wj-zhe/thrfv/case/case_dxf/thrfv_case_bottom-Edge_Cuts.dxf

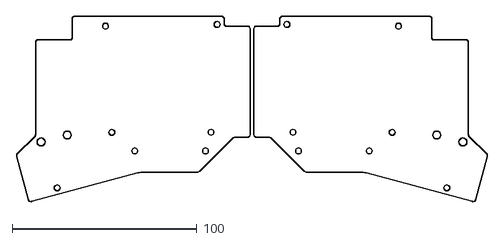
[picture p1: CAD file, 2023-05-11]
case/case_dxf/thrfv_case_bottom-Edge_Cuts.dxf
254.9 x 100.2
