wj-zhe/thrfv/case/encoder_on_left_no_joystick/case_dxf/thrfv_case_switch_plate-Edge_Cuts.dxf

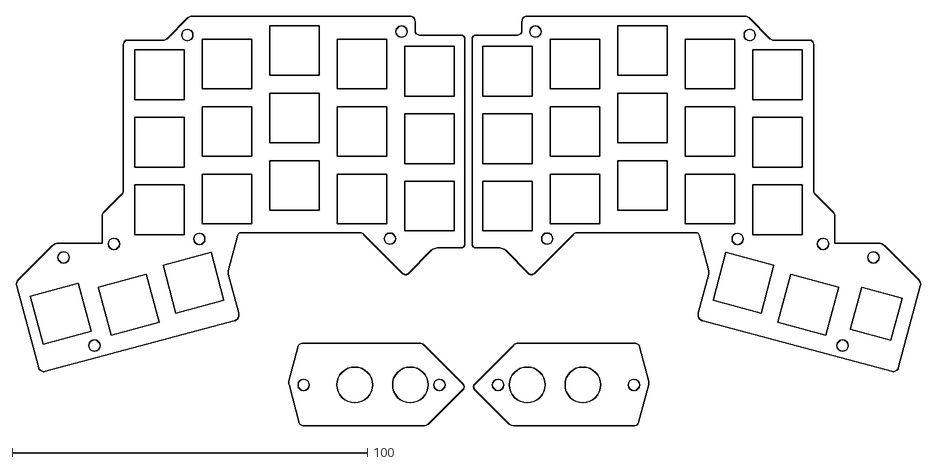
[picture p2: CAD file, 2023-05-11]
case/encoder_on_left_no_joystick/case_dxf/thrfv_case_switch_plate-Edge_Cuts.dxf
254.9 x 115.4
