wj-zhe/thrfv/case/encoder_on_left_no_joystick/case_dxf/thrfv_case_beneath_pcb-Edge_Cuts.dxf

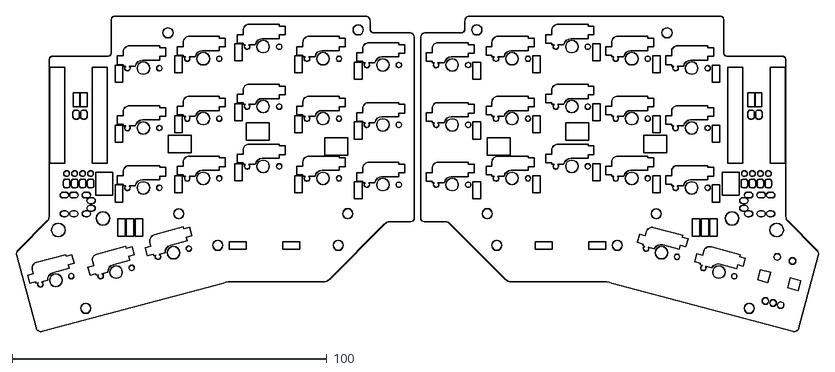
[picture p3: CAD file, 2023-05-11]
case/encoder_on_left_no_joystick/case_dxf/thrfv_case_beneath_pcb-Edge_Cuts.dxf
254.9 x 100.2
