wj-zhe/thrfv/PCB/thrfv.kicad_pcb

## KiCad design PCB/thrfv.kicad_pcb (2023-05-11)

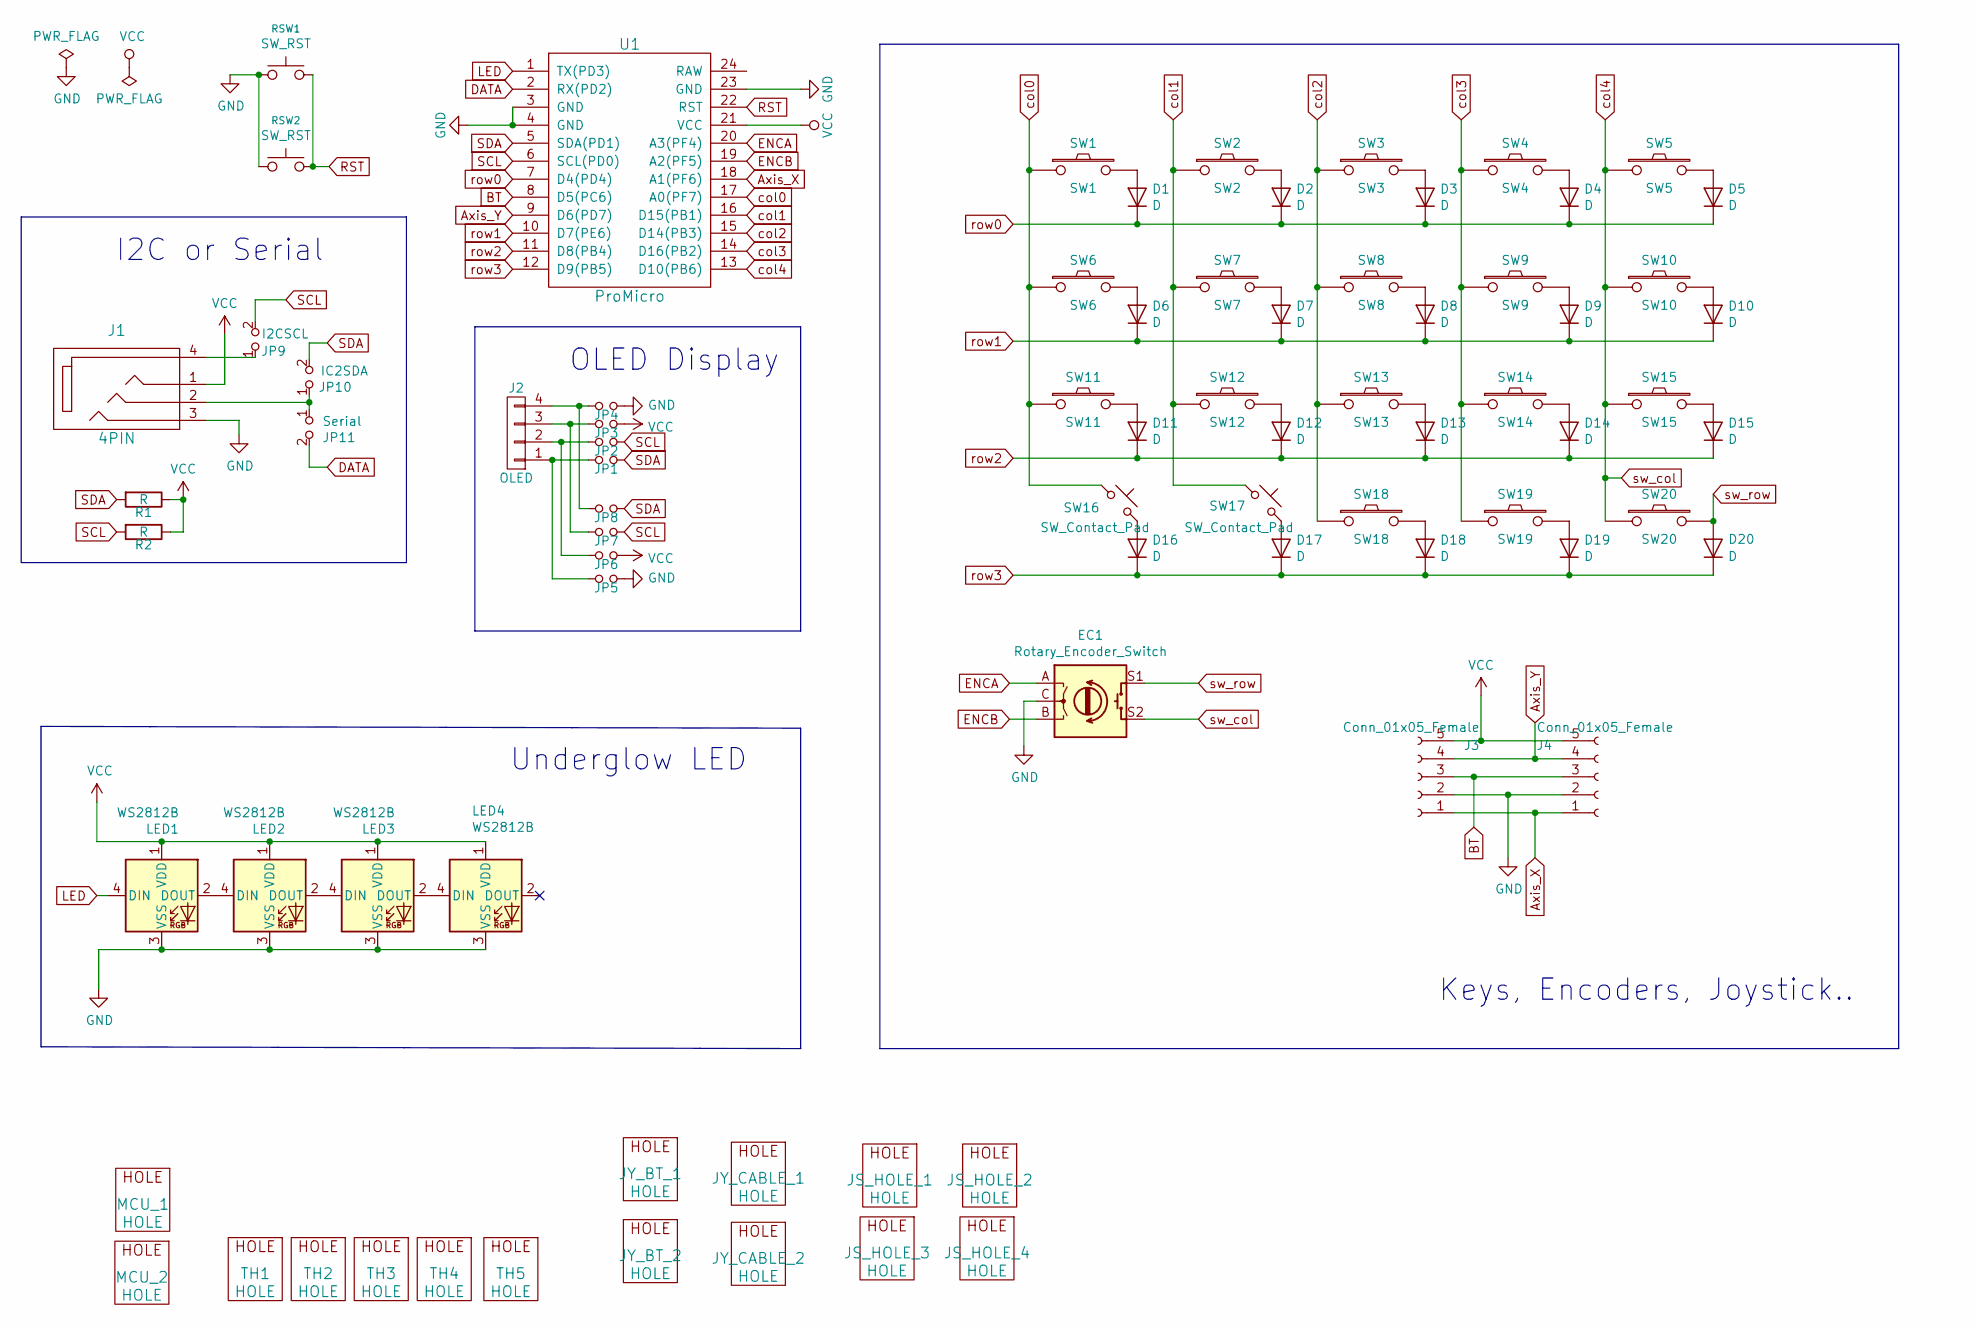
[picture p5: schematic thrfv.kicad_sch]

Parts:
D1, D2, D3, D4, D5, D6, D7, D8, D9, D10, D11, D12, D13, D14, D15, D16, D17, D18, D19, D20: D; Diode_SOD123_THT_2
EC1: Rotary_Encoder_Switch; RotaryEncoder_Alps_EC11E-Switch_Vertical_H20mm
J1: 4PIN; MJ-4PP-9
J2: OLED; OLED_4Pin
J3, J4: Conn_01x05_Female; TE_0-1734839-5_1x05-1MP_P0.5mm_Horizontal
JP1: JP1; SolderJumper-2_P1.3mm_Open_RoundedPad1.0x1.5mm
JP2: JP2; SolderJumper-2_P1.3mm_Open_RoundedPad1.0x1.5mm
JP3: JP3; SolderJumper-2_P1.3mm_Open_RoundedPad1.0x1.5mm
JP4: JP4; SolderJumper-2_P1.3mm_Open_RoundedPad1.0x1.5mm
JP5: JP5; SolderJumper-2_P1.3mm_Open_RoundedPad1.0x1.5mm
JP6: JP6; SolderJumper-2_P1.3mm_Open_RoundedPad1.0x1.5mm
JP7: JP7; SolderJumper-2_P1.3mm_Open_RoundedPad1.0x1.5mm
JP8: JP8; SolderJumper-2_P1.3mm_Open_RoundedPad1.0x1.5mm
JP9: I2CSCL; SolderJumper-2_P1.3mm_Open_RoundedPad1.0x1.5mm
JP10: IC2SDA; SolderJumper-2_P1.3mm_Open_RoundedPad1.0x1.5mm
JP11: Serial; SolderJumper-2_P1.3mm_Open_RoundedPad1.0x1.5mm
JS_HOLE_1, JS_HOLE_2, JS_HOLE_3, JS_HOLE_4: HOLE; MountingHole_2.7mm_M2.5
JY_BT_1, JY_BT_2: HOLE; MountingHole_3.2mm_M3
JY_CABLE_1, JY_CABLE_2: HOLE; Mounting_Hole_7x3mm
LED1, LED2, LED3, LED4: WS2812B; LED_WS2812B_PLCC4_5.0x5.0mm_P3.2mm_double_side
MCU_1, MCU_2: HOLE; MountingHole_2.2mm_M2_Pad
R1, R2: R; R_1206_DoubleSided
RSW1, RSW2: SW_RST; SW_SPST_TL3342
SW1: SW1; CherryMX_Hotswap
SW2: SW2; CherryMX_Hotswap
SW3: SW3; CherryMX_Hotswap
SW4: SW4; CherryMX_Hotswap
SW5: SW5; CherryMX_Hotswap
SW6: SW6; CherryMX_Hotswap
SW7: SW7; CherryMX_Hotswap
SW8: SW8; CherryMX_Hotswap
SW9: SW9; CherryMX_Hotswap
SW10: SW10; CherryMX_Hotswap
SW11: SW11; CherryMX_Hotswap
SW12: SW12; CherryMX_Hotswap
SW13: SW13; CherryMX_Hotswap
SW14: SW14; CherryMX_Hotswap
SW15: SW15; CherryMX_Hotswap
SW16, SW17: SW_Contact_Pad; contact_button_pad_half_circle_3mm
SW18: SW18; CherryMX_Hotswap
SW19: SW19; CherryMX_Hotswap
SW20: SW20; CherryMX_Hotswap
TH1, TH2, TH3, TH4, TH5: HOLE; MountingHole_3.2mm_M3
U1: ProMicro; ProMicro_jumper_pad_only

Connections:
Axis_X: J3.1, J4.1, U1.18 (A1(PF6))
Axis_Y: J3.4, J4.4, U1.9 (D6(PD7))
BT: J3.3, J4.3, U1.8 (D5(PC6))
DATA: JP11.2, U1.2 (RX(PD2))
ENCA: EC1.A, U1.20 (A3(PF4))
ENCB: EC1.B, U1.19 (A2(PF5))
GND: EC1.C, J1.3, J3.2, J4.2, JP4.2, JP5.2, LED1.3 (VSS), LED2.3 (VSS), LED3.3 (VSS), LED4.3 (VSS), RSW1.1, RSW2.1, U1.3 (GND), U1.4 (GND), U1.23 (GND)
LED: LED1.4 (DIN), U1.1 (TX(PD3))
unnamed: D1.2 (A), SW1.2
unnamed: D2.2 (A), SW2.2
unnamed: D3.2 (A), SW3.2
unnamed: D4.2 (A), SW4.2
unnamed: D5.2 (A), SW5.2
unnamed: D6.2 (A), SW6.2
unnamed: D7.2 (A), SW7.2
unnamed: D8.2 (A), SW8.2
unnamed: D9.2 (A), SW9.2
unnamed: D10.2 (A), SW10.2
unnamed: D11.2 (A), SW11.2
unnamed: D12.2 (A), SW12.2
unnamed: D13.2 (A), SW13.2
unnamed: D14.2 (A), SW14.2
unnamed: D15.2 (A), SW15.2
unnamed: D16.2 (A), SW16.2
unnamed: D17.2 (A), SW17.2
unnamed: D18.2 (A), SW18.2
unnamed: D19.2 (A), SW19.2
unnamed: J1.2, JP10.1, JP11.1
unnamed: J1.4, JP9.1
unnamed: J2.1, JP1.1, JP5.1
unnamed: J2.2, JP2.1, JP6.1
unnamed: J2.3, JP3.1, JP7.1
unnamed: J2.4, JP4.1, JP8.1
unnamed: LED1.2 (DOUT), LED2.4 (DIN)
unnamed: LED2.2 (DOUT), LED3.4 (DIN)
unnamed: LED3.2 (DOUT), LED4.4 (DIN)
RST: RSW1.2, RSW2.2, U1.22 (RST)
SCL: JP2.2, JP7.2, JP9.2, R2.2, U1.6 (SCL(PD0))
SDA: JP1.2, JP8.2, JP10.2, R1.2, U1.5 (SDA(PD1))
VCC: J1.1, J3.5, J4.5, JP3.2, JP6.2, LED1.1 (VDD), LED2.1 (VDD), LED3.1 (VDD), LED4.1 (VDD), R1.1, R2.1, U1.21 (VCC)
col0: SW1.1, SW6.1, SW11.1, SW16.1, U1.17 (A0(PF7))
col1: SW2.1, SW7.1, SW12.1, SW17.1, U1.16 (D15(PB1))
col2: SW3.1, SW8.1, SW13.1, SW18.1, U1.15 (D14(PB3))
col3: SW4.1, SW9.1, SW14.1, SW19.1, U1.14 (D16(PB2))
col4: EC1.S2, SW5.1, SW10.1, SW15.1, SW20.1, U1.13 (D10(PB6))
row0: D1.1 (K), D2.1 (K), D3.1 (K), D4.1 (K), D5.1 (K), U1.7 (D4(PD4))
row1: D6.1 (K), D7.1 (K), D8.1 (K), D9.1 (K), D10.1 (K), U1.10 (D7(PE6))
row2: D11.1 (K), D12.1 (K), D13.1 (K), D14.1 (K), D15.1 (K), U1.11 (D8(PB4))
row3: D16.1 (K), D17.1 (K), D18.1 (K), D19.1 (K), D20.1 (K), U1.12 (D9(PB5))
sw_row: D20.2 (A), EC1.S1, SW20.2

Notes on the sheet:
Keys, Encoders, Joystick..
OLED Display
Underglow LED
I2C or Serial

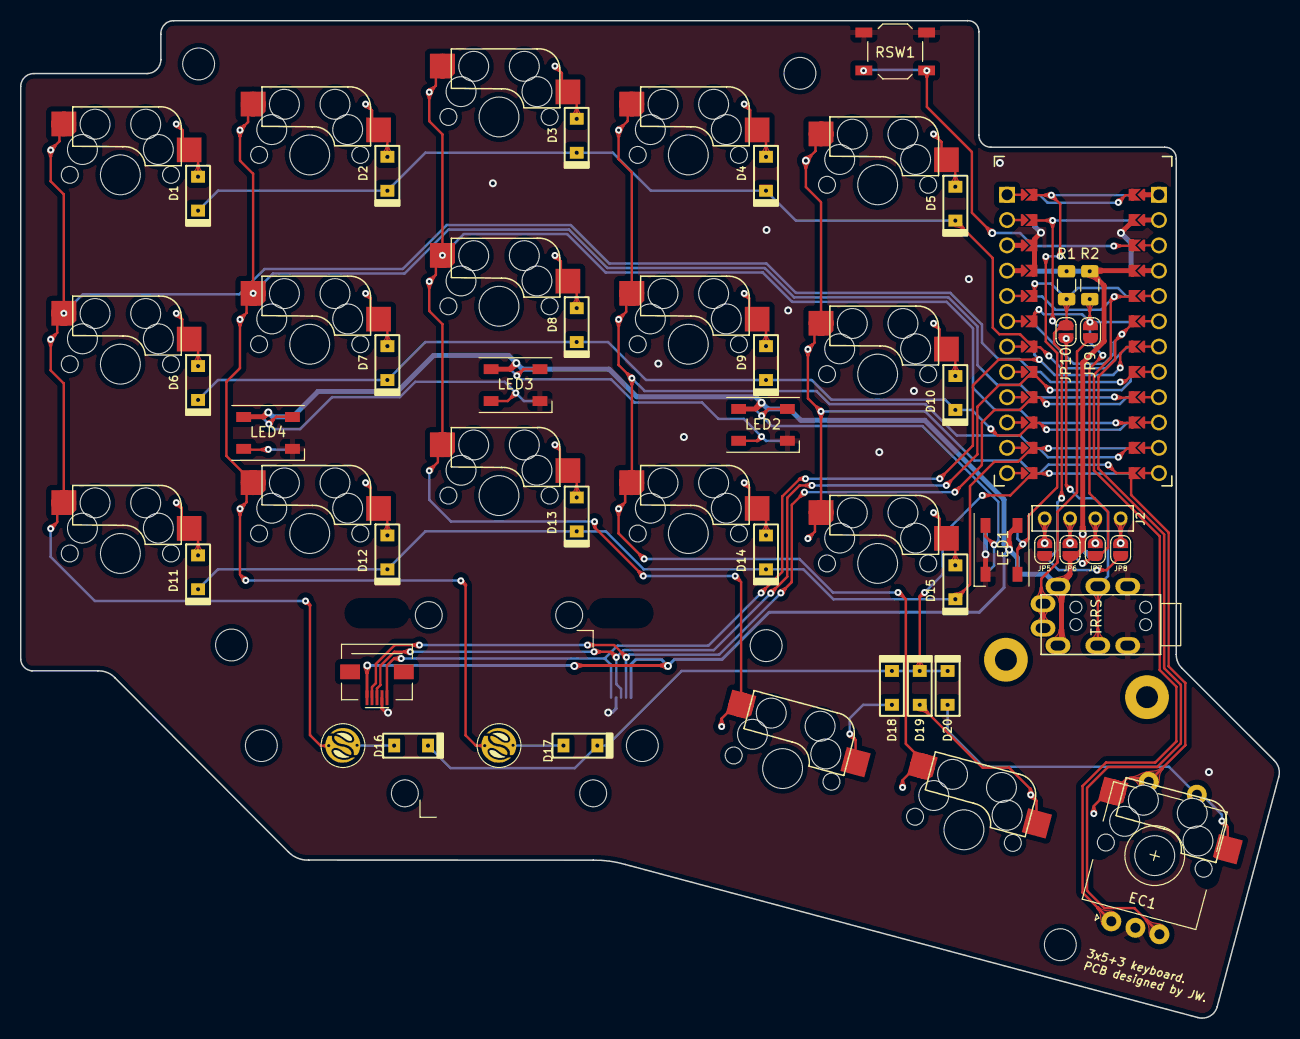
[picture p6: board thrfv.kicad_pcb from above]

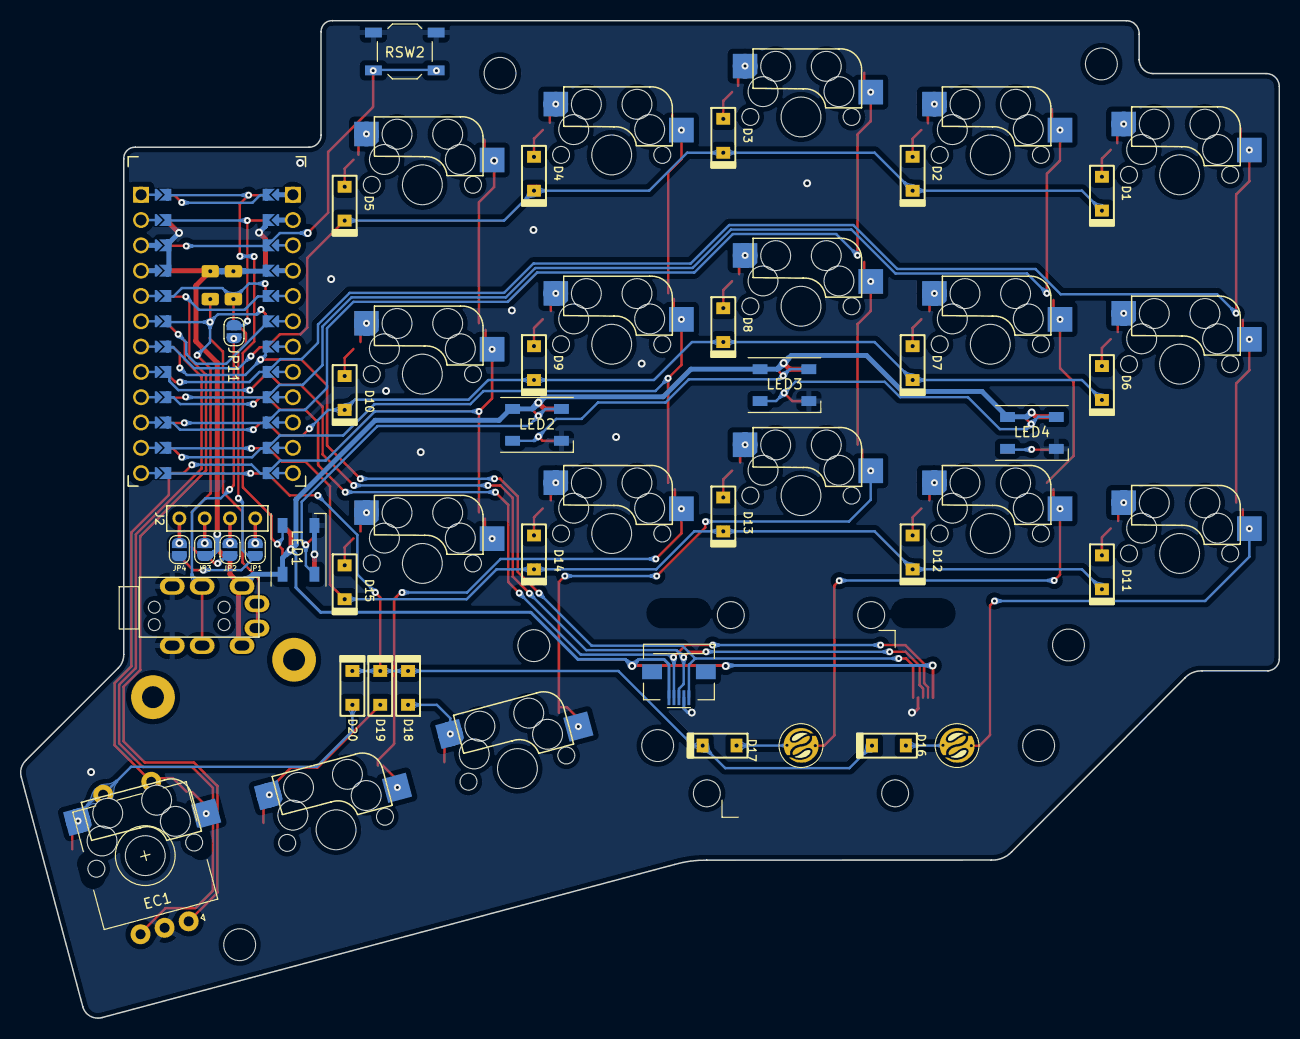
[picture p7: board thrfv.kicad_pcb from below]

Board: 2 copper layers, 126.3 x 100.1 mm, 80 parts (8 on the bottom side), 50 nets.
