wj-zhe/thrfv/firmware/keymaps/homerow/thrfv_oled.h

/* oled_rotation_t oled_init_user(oled_rotation_t rotation) { */
/* 	return OLED_ROTATION_270; */
/* } */

static void render_qmk_logo(void) {
    static const char PROGMEM qmk_logo[] = {
        0x80,0x81,0x82,0x83,0x84,0x85,0x86,0x87,0x88,0x89,0x8a,0x8b,0x8c,0x8d,0x8e,0x8f,0x90,0x91,0x92,0x93,0x94,
        0xa0,0xa1,0xa2,0xa3,0xa4,0xa5,0xa6,0xa7,0xa8,0xa9,0xaa,0xab,0xac,0xad,0xae,0xaf,0xb0,0xb1,0xb2,0xb3,0xb4,
        0xc0,0xc1,0xc2,0xc3,0xc4,0xc5,0xc6,0xc7,0xc8,0xc9,0xca,0xcb,0xcc,0xcd,0xce,0xcf,0xd0,0xd1,0xd2,0xd3,0xd4,0};

    oled_write_P(qmk_logo, false);
}

static void render_status(void) {
    // Layer info
    oled_write_P(PSTR("Layer: "), false);
    switch (get_highest_layer(layer_state)) {
        case 0:
            oled_write_P(PSTR("Default\n"), false);
            break;
        case 1:
            oled_write_P(PSTR("Num_Sym\n"), false);
            break;
        case 2:
            oled_write_P(PSTR("Move_F\n"), false);
            break;
        case 3:
            oled_write_P(PSTR("Numpad_Adj\n"), false);
            break;
        default:
            // Or use the write_ln shortcut over adding '\n' to the end of your string
            oled_write_ln_P(PSTR("Undefined\n"), false);
    }

    // Host Keyboard LED Status
    led_t led_state = host_keyboard_led_state();
    oled_write_P(PSTR("LOCK: "), false);
    oled_write_P(led_state.caps_lock ? PSTR("CAP ") : PSTR("    "), false);
    oled_write_P(led_state.num_lock ? PSTR("NUM ") : PSTR("    "), false);
    oled_write_P(led_state.scroll_lock ? PSTR("SCR ") : PSTR("    "), false);

}

// render different content on two displays
bool oled_task_user(void) {
    if (is_keyboard_master()) {
        render_status();  // Renders the current keyboard state (layer, lock, caps, scroll, etc)
    } else {
        render_qmk_logo();  // Renders a static logo
        oled_scroll_left();  // Turns on scrolling
    }

    return false;
}
