wj-zhe/thrfv/(commit log)

2022-07-06 3x5 keyboard with rotary encoder, Nintendo Switch Joystick and contact pad switches in the shape (roughly) of AT-ST (All Terrain Scout Transports).
    [no_name.kicad_pcb, no_name.kicad_sch]
2022-07-06 Renamed files + minor changes.
    [no_name.kicad_pcb, no_name.kicad_sch]
2022-07-06 Corrected Joystick cable hole error.
    [AT_ST.kicad_pcb, AT_ST.kicad_sch]
2022-07-06 Some more changes.
    [AT_ST.kicad_pcb]
2022-07-06 Updated some footprints.
    [AT_ST.kicad_pcb, AT_ST.kicad_sch]
2022-07-06 1. Modified some trace and via location. 2. Included gerber files.
    [AT_ST.kicad_pcb]
2022-07-08 1. Correct a serious pin allocation problem, where a digital pin was assigned for joystick Y axis. 2. Updated MX switches footprints. 3. Included flip style 5 pins FPC/FFC socket. 4. Minor changes he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
    [AT_ST-B_Cu.gbl, AT_ST-B_Mask.gbs, AT_ST-B_Paste.gbp, AT_ST-B_Silkscreen.gbo, AT_ST-Edge_Cuts.gm1, AT_ST-F_Cu.gtl, AT_ST-F_Mask.gts, AT_ST-F_Paste.gtp]
2022-07-08 Re-plotted gerber files.
    [AT_ST-B_Cu.gbl, AT_ST-B_Mask.gbs, AT_ST-B_Paste.gbp, AT_ST-B_Silkscreen.gbo, AT_ST-Edge_Cuts.gm1, AT_ST-F_Cu.gtl, AT_ST-F_Mask.gts, AT_ST-F_Paste.gtp]
2022-07-10 1. Repository renamed from AT_ST to thrfv, aka three-by-five, 3x5 2. Multiple twists.
    [AT_ST.kicad_pcb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]
2022-07-10 Minor changes here and there.
    [thrfv-B_Cu.gbl, thrfv-B_Mask.gbs, thrfv-B_Silkscreen.gbo, thrfv-Edge_Cuts.gm1, thrfv-F_Cu.gtl, thrfv-F_Mask.gts, thrfv-F_Silkscreen.gto, thrfv-NPTH.drl]
2022-07-14 No comment.
    [thrfv-B_Cu.gbl, thrfv-B_Mask.gbs, thrfv-B_Silkscreen.gbo, thrfv-Edge_Cuts.gm1, thrfv-F_Cu.gtl, thrfv-F_Mask.gts, thrfv-F_Silkscreen.gto, thrfv-NPTH.drl]
2022-07-17 Multiple changes. Re-plotted gerber files.
    [thrfv-B_Cu.gbl, thrfv-B_Mask.gbs, thrfv-B_Silkscreen.gbo, thrfv-Edge_Cuts.gm1, thrfv-F_Cu.gtl, thrfv-F_Mask.gts, thrfv-F_Silkscreen.gto, thrfv-NPTH.drl]
2022-07-19 First PCB production.
    [thrfv-B_Cu.gbl, thrfv-B_Mask.gbs, thrfv-B_Silkscreen.gbo, thrfv-Edge_Cuts.gm1, thrfv-F_Cu.gtl, thrfv-F_Mask.gts, thrfv-F_Silkscreen.gto, thrfv-NPTH.drl]
2022-07-22 Created files for acrylic stack case.
    [thrfv_case_above_PCB.kicad_pcb, thrfv_case_above_PCB_js_on_right-Edge_Cuts.dxf, thrfv_case_above_PCB_js_on_right.kicad_pcb, thrfv_case_beneath_PCB.kicad_pcb, thrfv_case_beneath_PCB_js_on_right-Edge_Cuts.dxf, thrfv_case_beneath_PCB_js_on_right.kicad_pcb, thrfv_case_bottom.kicad_pcb, thrfv_case_bottom_js_on_right-Edge_Cuts.dxf]
2023-05-11 Fixed bug related to encoder.h naming.
    [config.h, keymap.c, tap_dances.h]
2023-10-14 Updated firmware: included advanced encoder functions, etc.
